15262764499/e-paper/docs/superpowers/plans/2026-09-17-pulse-mcu.md

# Pulse MCU Implementation Plan

**Goal:** Implement the already agreed desktop Pulse v1 protocol on USART1 and build application + bootloader on this Windows computer.
**Architecture:** Bounded interrupt RX ring, main-context protocol parsing and ACKs, pure testable parser/effect, SysTick animation and 3-second expiry. NFC remains a temporary override; local mode selection cancels computer control. STOP/expiry select OFF. No flashing in this task.
**Tech Stack:** STM32 HAL, C, native GCC tests, Arm GNU GCC, MinGW Make, PowerShell.

- [x] Write native regression for desktop golden packets, fragmentation/CRC/resync/invalid parameters, animation continuity, timeout and tick wrap.
- [x] Add pulse_protocol.c/.h and pulse_effect.h; run regression.
- [x] Connect bounded USART1 RX interrupt and callbacks; poll in main and HAL_Delay, preserve USART2 BLE.
- [x] Integrate computer effect into led_595.c; test existing hardware driver mock and local/NFC arbitration.
- [x] Install official Arm toolchain locally; make both Makefiles Windows-compatible; provide build-mcu.ps1.
- [x] Compile application and bootloader, inspect memory/address output, review changes, document exact build and flash addresses.

Verified clean ARM build, protocol/UART/LED/HMAC native regressions, 43,200 desktop effect comparisons and 21 desktop tests. Independent static review found no blocking issue. Hardware flashing/testing remains outside this task.
