15262764499/e-paper/docs/superpowers/plans/2026-09-16-pulse-background.md

# Pulse 1.1 后台运行

用户已确认增加后台功能；只改 Windows 程序，不修改固件。

- [x] 托盘菜单：恢复窗口、暂停/恢复、后台设置、退出。
- [x] 关闭驻留默认开启；保留采集和串口线程，隐藏时降低预览刷新频率。
- [x] 显式退出异步等待工作线程清理；无托盘时显示窗口并正常退出。
- [x] 可选登录自启动、手动启动隐藏；只操作本应用当前用户启动项。
- [x] 后台设置界面、使用说明、版本号更新。
- [x] 单元/集成测试及代码审查；模拟设备验证隐藏期间持续更新。

启动不自动打开串口。登录后首次连接仍需恢复窗口并手动连接；已连接后隐藏窗口不影响通信。
