15262764499/e-paper/3d外壳/顶盖1.STEP

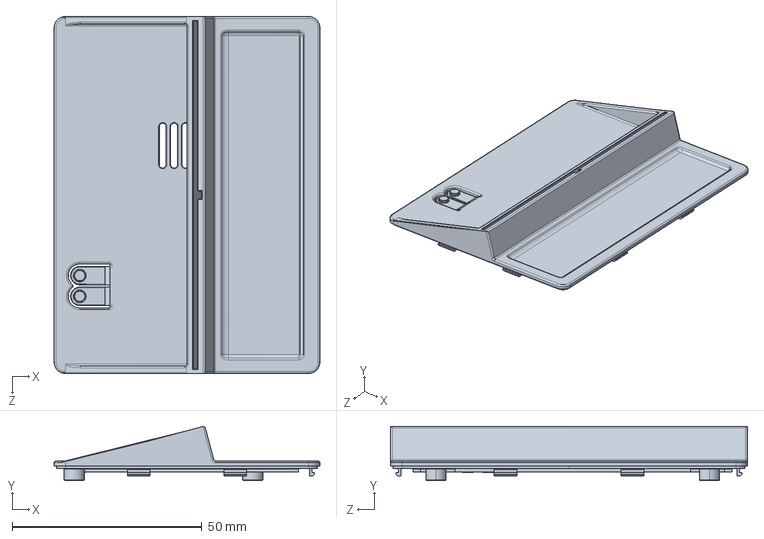
[picture p4: CAD file, 2026-09-23]
3d外壳/顶盖1.STEP
70.0 x 14.3 x 94.0 mm
