15262764499/e-paper/3d外壳/底座1.STEP

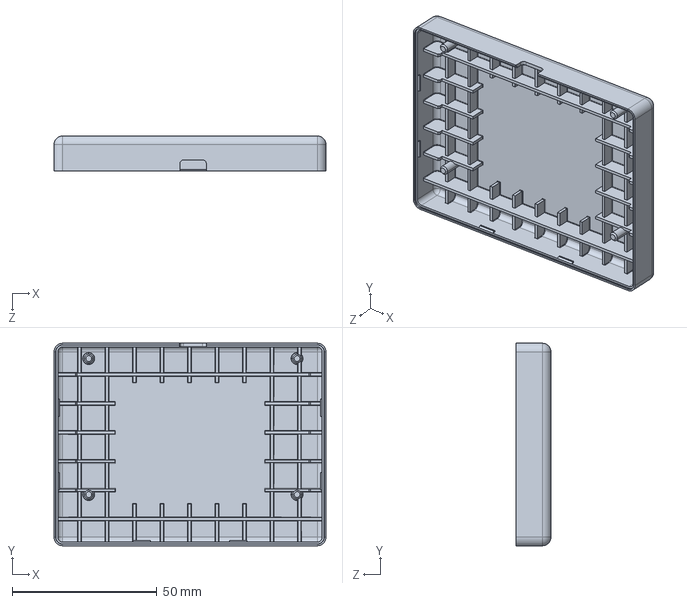
[picture p5: CAD file, 2026-09-23]
3d外壳/底座1.STEP
94.0 x 70.0 x 12.1 mm
