15262764499/e-paper/(list of files, cad)

Other CAD files:
3d外壳/Screen_FPC.blend
