15262764499/e-paper/files/SCH_Schematic3_2026-09-11.pdf

NFC感应模块 | NFC供电控制

## 温湿度传感器

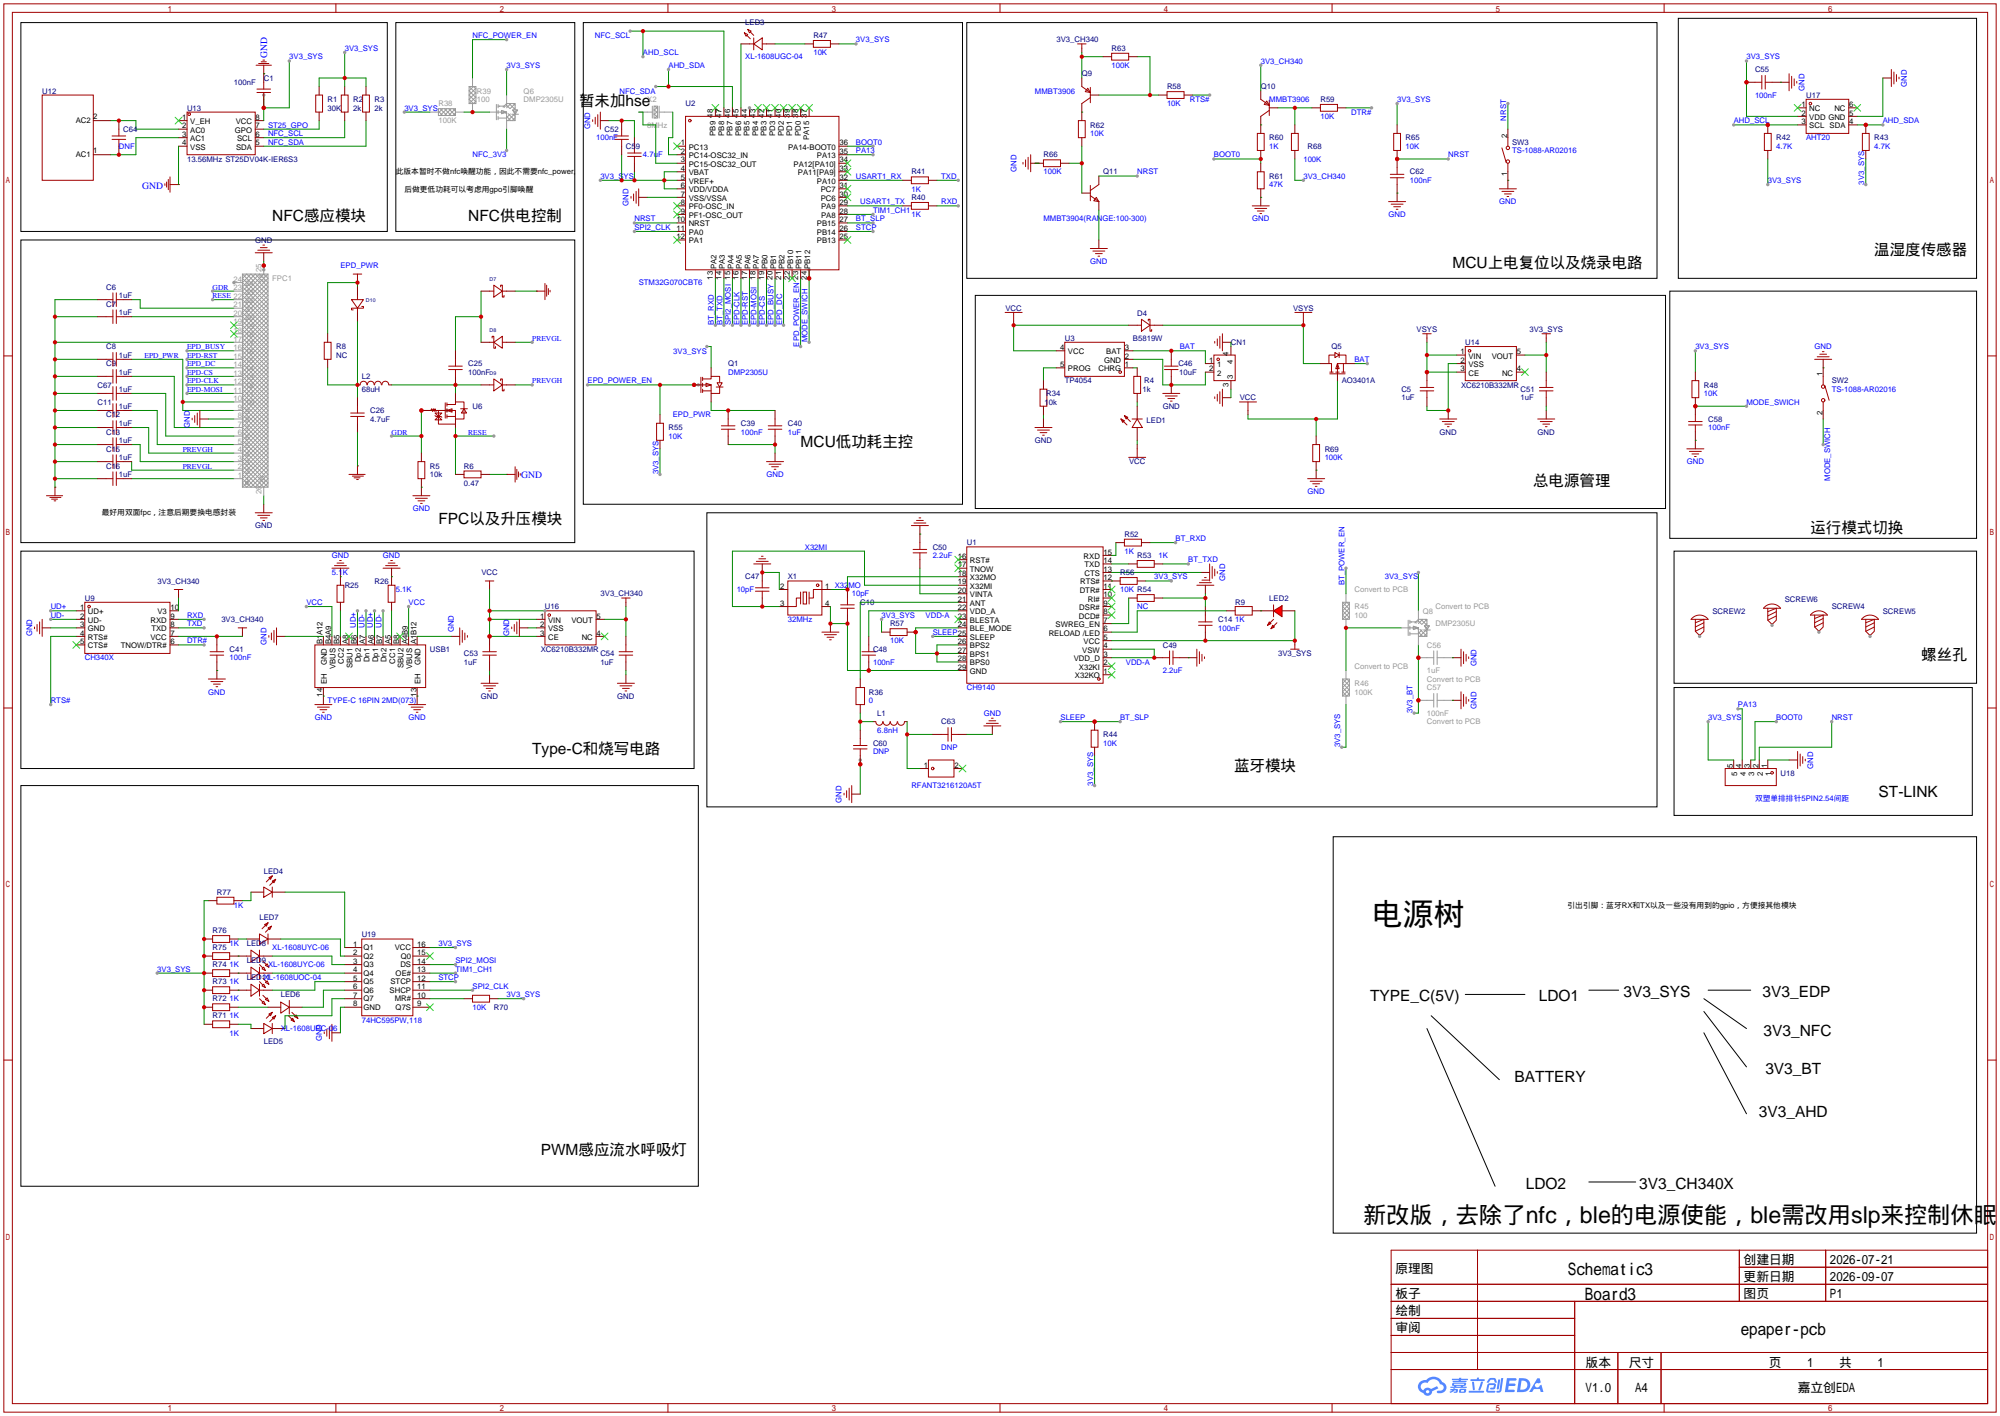
[picture p6: page 1]

RI# 10 DTR# 11 RTS# 12 CTS 13 TXD 14 RXD 15

GND A1B12 VBUS A4B9 SBU2 B8 CC1 A5 Dn2 B7 Dp1 A6 Dn1 A7 Dp2 B6 SBU1 A8 CC2 B5 VBUS B4A9 GND B1A12 EH 14 EH 13

MR# 10 SHCP 11 STCP 12 OE# 13 DS 14 Q0 15 VCC 16

新改版，去除了nfc，ble的电源使能，ble需改用slp来控制休眠

原理图 | Schematic3 | 创建日期 | 2026-07-21

更新日期 | 2026-09-07

板子 | Board3 | 图页 | P1
绘制 | | epaper-pcb
审阅

V1.0 | A4 | 嘉立创EDA
