15262764499/e-paper/Core/Inc/main.h

#define BT_RXD_Pin GPIO_PIN_2
#define BT_RXD_GPIO_Port GPIOA
#define BT_TXD_Pin GPIO_PIN_3
#define BT_TXD_GPIO_Port GPIOA
#define EPD_CLK_Pin GPIO_PIN_5
#define EPD_CLK_GPIO_Port GPIOA
#define EPD_RST_Pin GPIO_PIN_6
#define EPD_RST_GPIO_Port GPIOA
#define EPD_MOSI_Pin GPIO_PIN_7
#define EPD_MOSI_GPIO_Port GPIOA
#define EPD_CS_Pin GPIO_PIN_0
#define EPD_CS_GPIO_Port GPIOB
#define EPD_BUSY_Pin GPIO_PIN_1
#define EPD_BUSY_GPIO_Port GPIOB
#define EPD_DC_Pin GPIO_PIN_2
#define EPD_DC_GPIO_Port GPIOB
#define EPD_POWER_EN_Pin GPIO_PIN_11
#define EPD_POWER_EN_GPIO_Port GPIOB
#define MODE_SWICH_Pin GPIO_PIN_12
#define MODE_SWICH_GPIO_Port GPIOB
#define BT_SLP_Pin GPIO_PIN_15
#define BT_SLP_GPIO_Port GPIOB
#define CH340_RXD_Pin GPIO_PIN_9
#define CH340_RXD_GPIO_Port GPIOA
#define CH340_TXD_Pin GPIO_PIN_10
#define CH340_TXD_GPIO_Port GPIOA
#define NFC_SDA_AHD_SDA_Pin GPIO_PIN_7
#define NFC_SDA_AHD_SDA_GPIO_Port GPIOB
#define NFC_SCL_AHD_SCL_Pin GPIO_PIN_8
#define NFC_SCL_AHD_SCL_GPIO_Port GPIOB
