15262764499/e-paper/(commit log)

2026-09-15 固件v1.0.5
2026-09-15 添加电路设计文件
2026-09-17 删除了桌面端代码版本
2026-09-17 在跟新了串口打印的信息
2026-09-23 添加3d打印外壳文件
    [Screen_FPC.blend, 底座1.STEP, 顶盖1.STEP]
2026-09-23 删除杂项
